iOsnaaente/Medicao-de-consumo-de-agua/README.md

# Monitoramento do consumo de água em chuveiros com arduino e comunicação RF

  Com as crescentes noticias a cerca do uso de forma inadequada da água, uma das preocupações de toda comunidade científica e industrial mais conscientes, está sobre como reduzir o consumo de água através da conscientização das pessoas e criação de aparelhos que consigam economizar os recursos hídricos. Como forma de conscientização a Organização das Nações Unidas (ONU) criou no dia 22 de março de 1992, o Dia Mundial da Água, divulgando a Declaração Universal dos Direitos da Água, entretanto, pouca coisa mudou de lá para cá, pois, as pessoas não tem consciência de quantos litros de água elas gastam por dia e de que forma elas gastam esses recursos.

  Como forma de conscientização, nesse projeto será proposto a criação de um dispositivo que meça o volume de água gasto durante um banho e, que assim, a pessoa que esteja fazendo o uso do chuveiro, possa acompanhar esse consumo durante o processo. Acredita-se que com a visualização do volume total de água gasto durante um banho, o usuário tome consciência de quantos litros de água ele está desperdiçando, muitas vezes com coisas desnecessárias, e assim, o seu tempo de banho seja reduzido, economizando água consequentemente.

  Sabe-se da importância da conscientização a respeito do uso da água e é necessário ter-se os órgãos de apoio ao nosso lado nessa luta, para que se consiga, com sabedoria, usar a água plenamente e assim deixar-se um bom legado para as futuras gerações. Com cada um fazendo a sua parte e economizando, na medida do possível, conseguiremos manter um mundo mais saudável e sem o medo de como será no futuro, tudo graças a tecnologia. A água é um bem de todos e deve ser respeitada. 

# Montagem

Imagem do projeto de Receptor
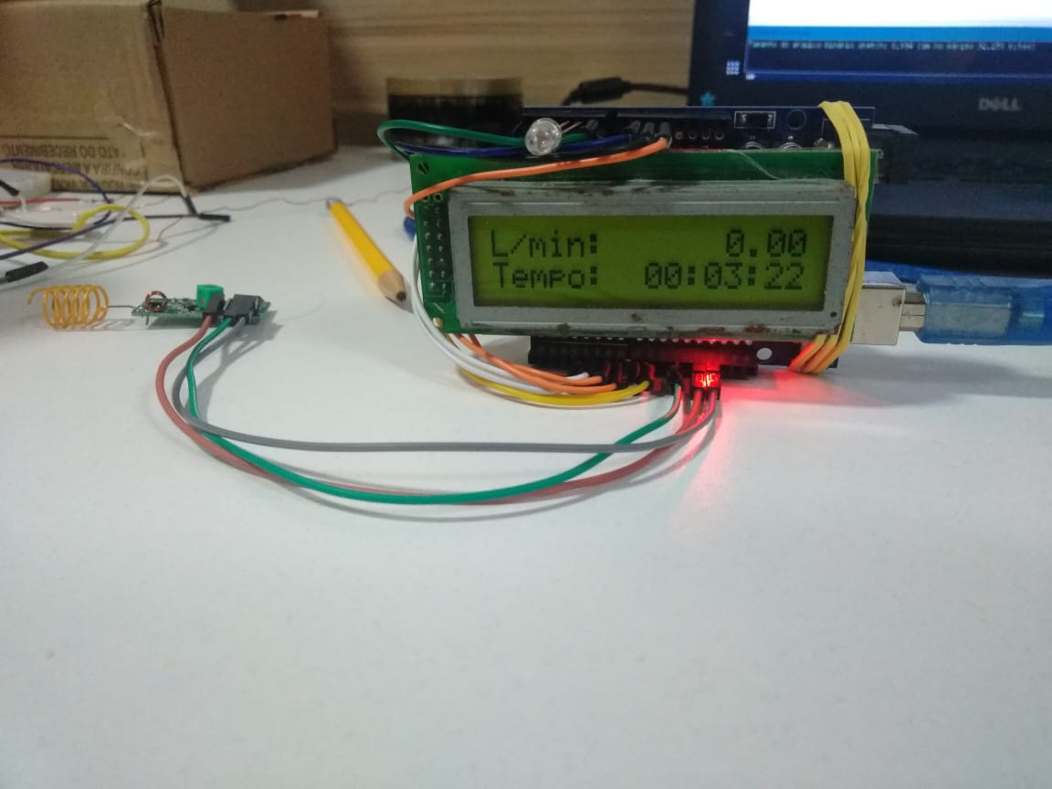
[picture p1: Imagens/Receptor_ (2).jpeg]


Imagem do projeto de Transmissor
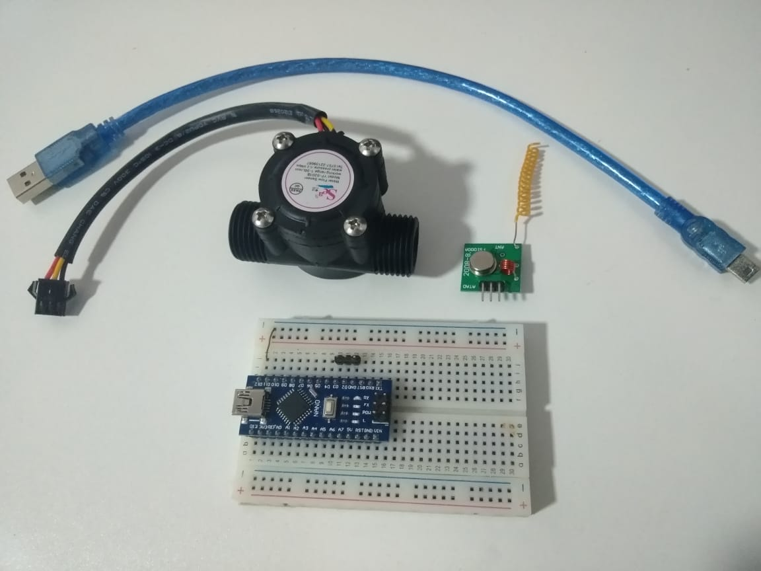
[picture p2: Imagens/Transmissor_ (2).jpeg]

 
 Para saber mais de como foi montado o sistema, visualize o doc.pdf disponível a cima.
 
 *Trabalho desenvolvido na disciplina de Microcontroladores para automação.*
 
 *Universidade Federal de Santa Maria - UFSM.*
