iOsnaaente/Medicao-de-consumo-de-agua/Imagens/Receptor_ (1).jpeg

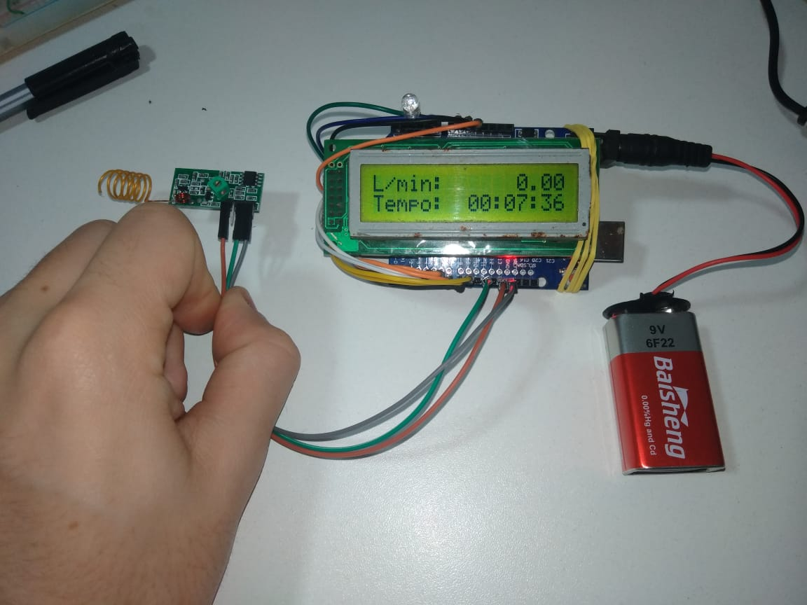
Imagens/Receptor_ (1).jpeg
