iOsnaaente/Medicao-de-consumo-de-agua/Imagens/Receptor_ (3).jpeg

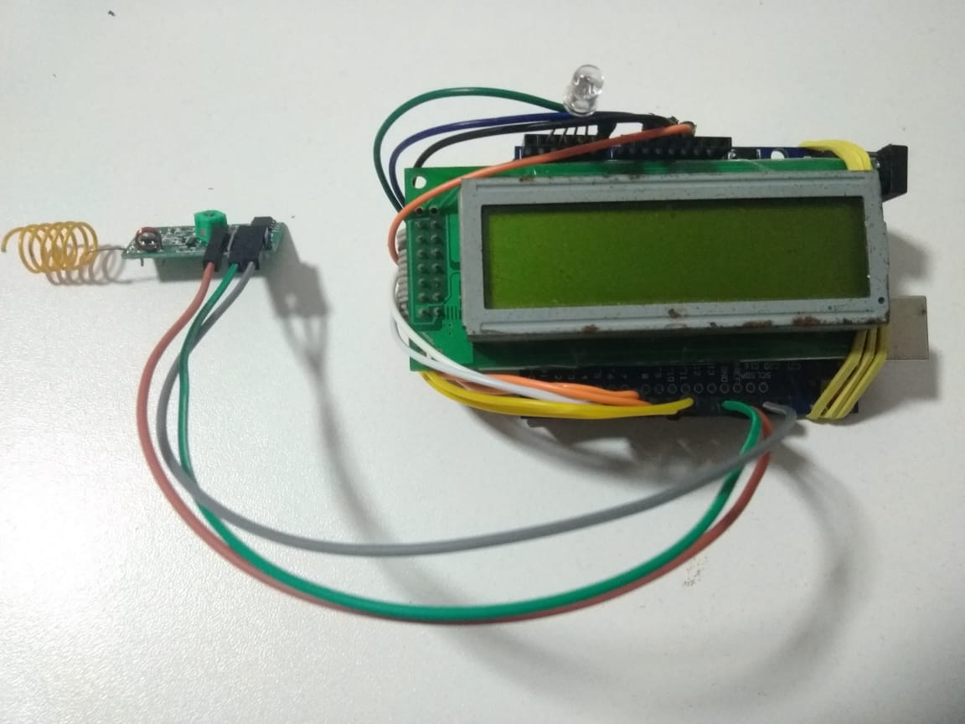
Imagens/Receptor_ (3).jpeg
