iOsnaaente/Medicao-de-consumo-de-agua/Imagens/Receptor_ (4).jpeg

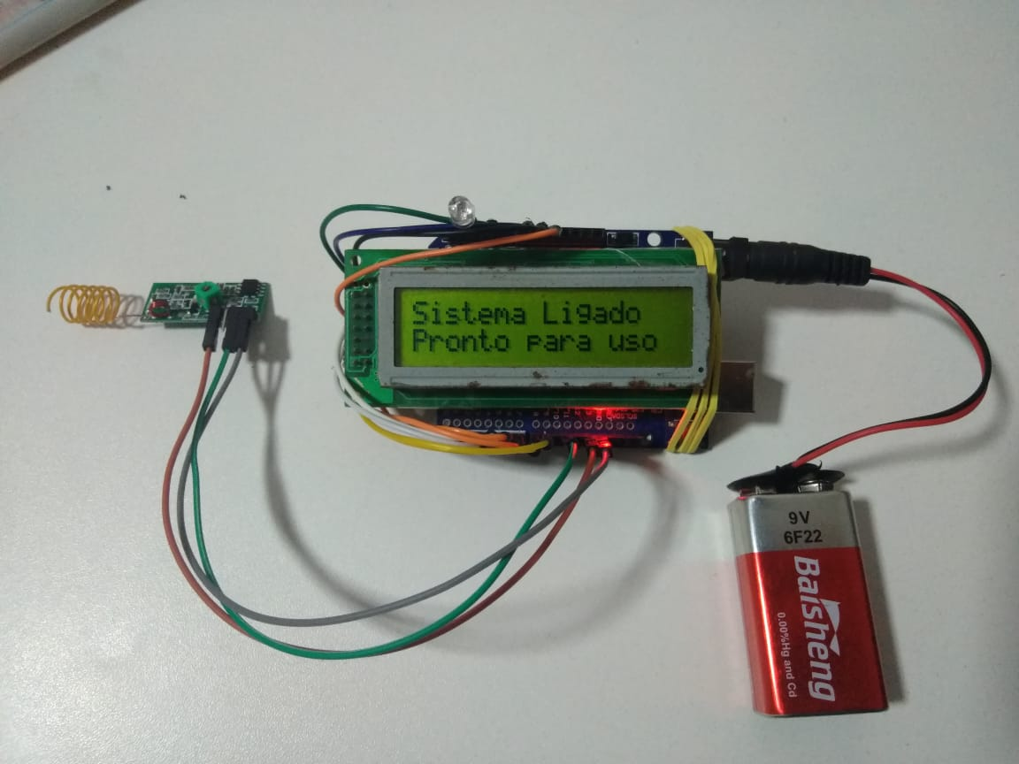
Imagens/Receptor_ (4).jpeg
