iOsnaaente/Medicao-de-consumo-de-agua/Imagens/Receptor_ (5).jpeg

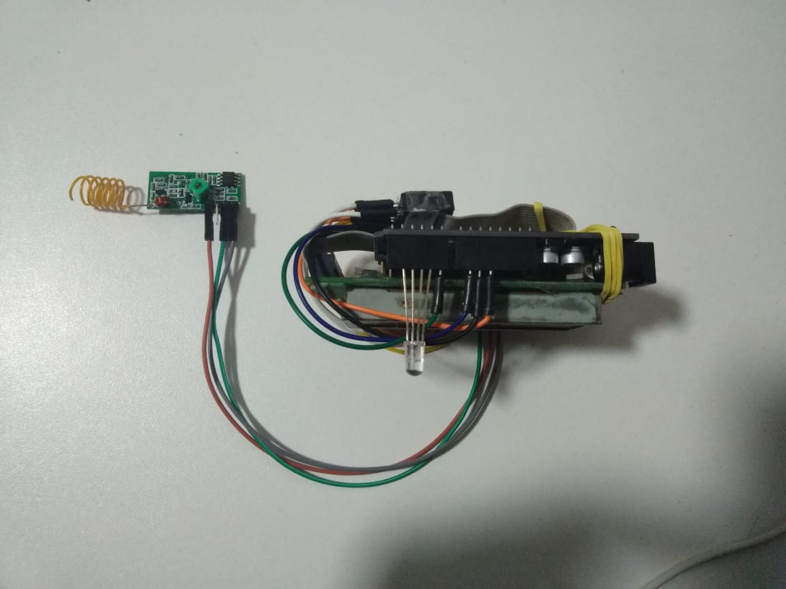
Imagens/Receptor_ (5).jpeg
