iOsnaaente/Medicao-de-consumo-de-agua/Imagens/Receptor_ (6).jpeg

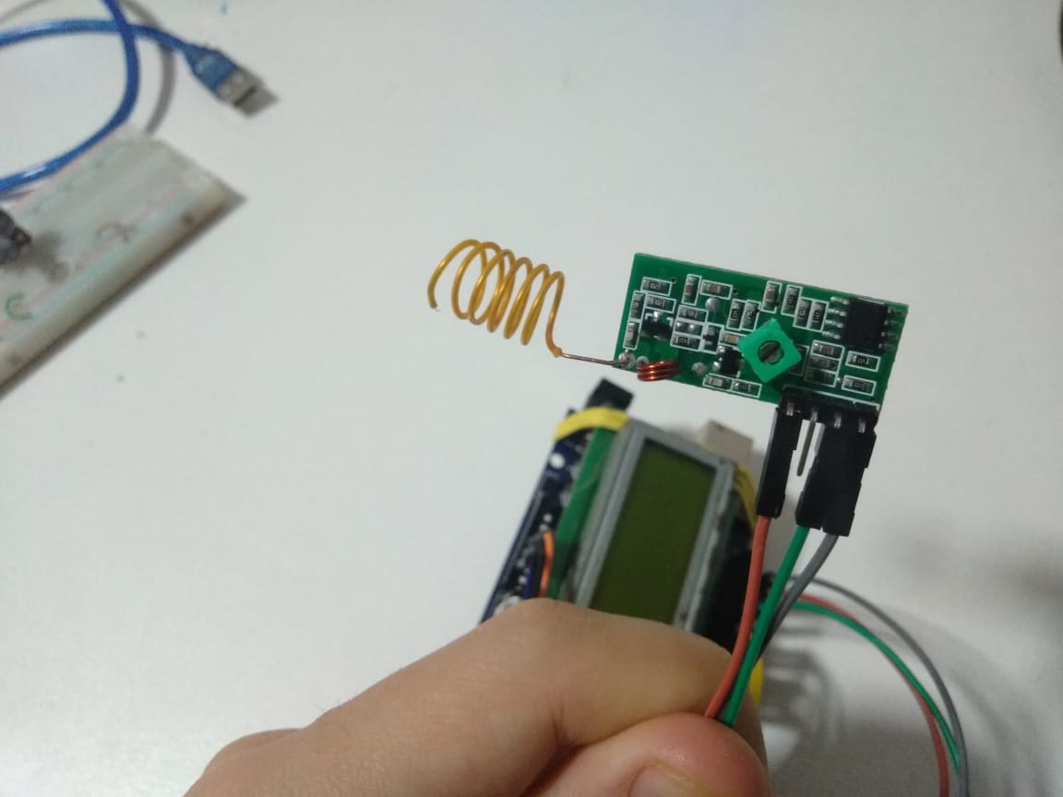
Imagens/Receptor_ (6).jpeg
