iOsnaaente/Medicao-de-consumo-de-agua/Imagens/Transmissor_ (1).jpeg

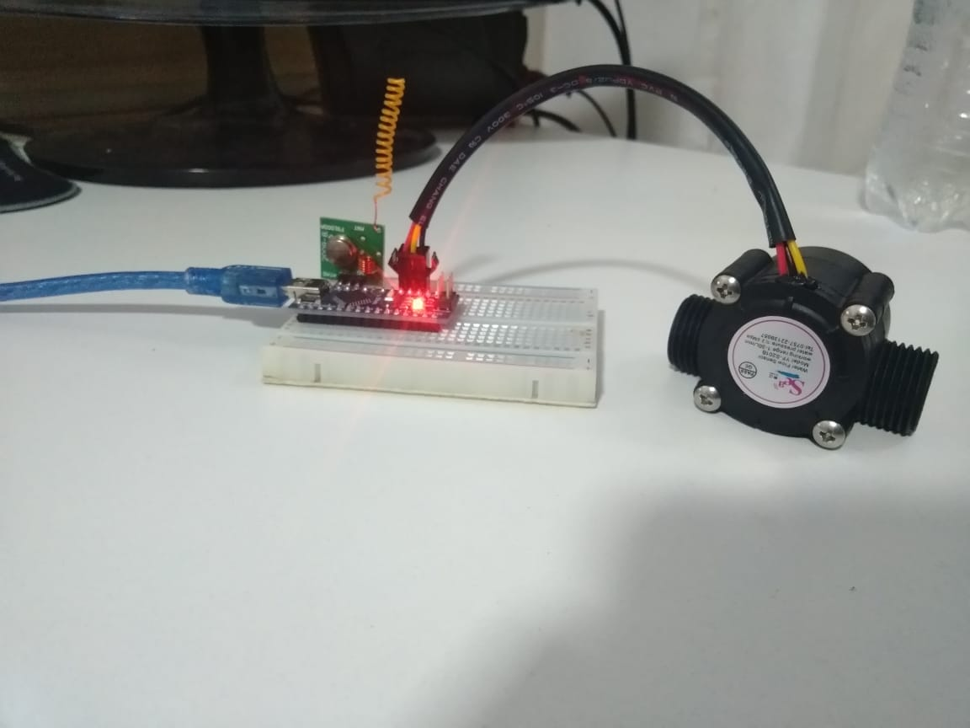
Imagens/Transmissor_ (1).jpeg
