iOsnaaente/Medicao-de-consumo-de-agua/Imagens/Transmissor_ (3).jpeg

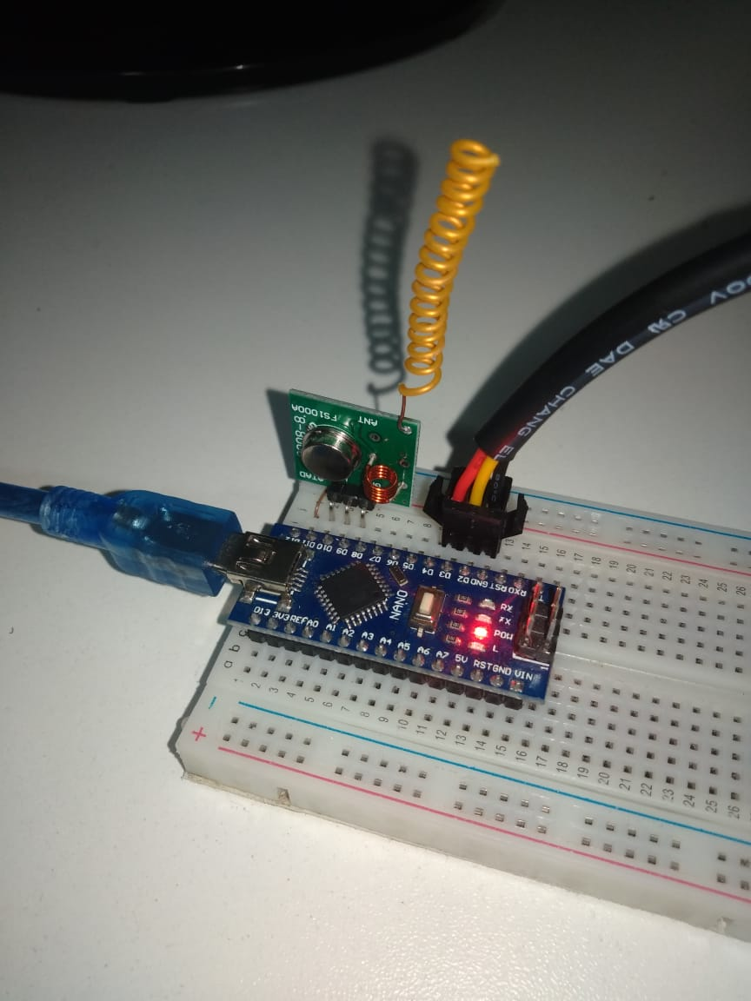
Imagens/Transmissor_ (3).jpeg
