iOsnaaente/Medicao-de-consumo-de-agua/Imagens/Transmissor_ (4).jpeg

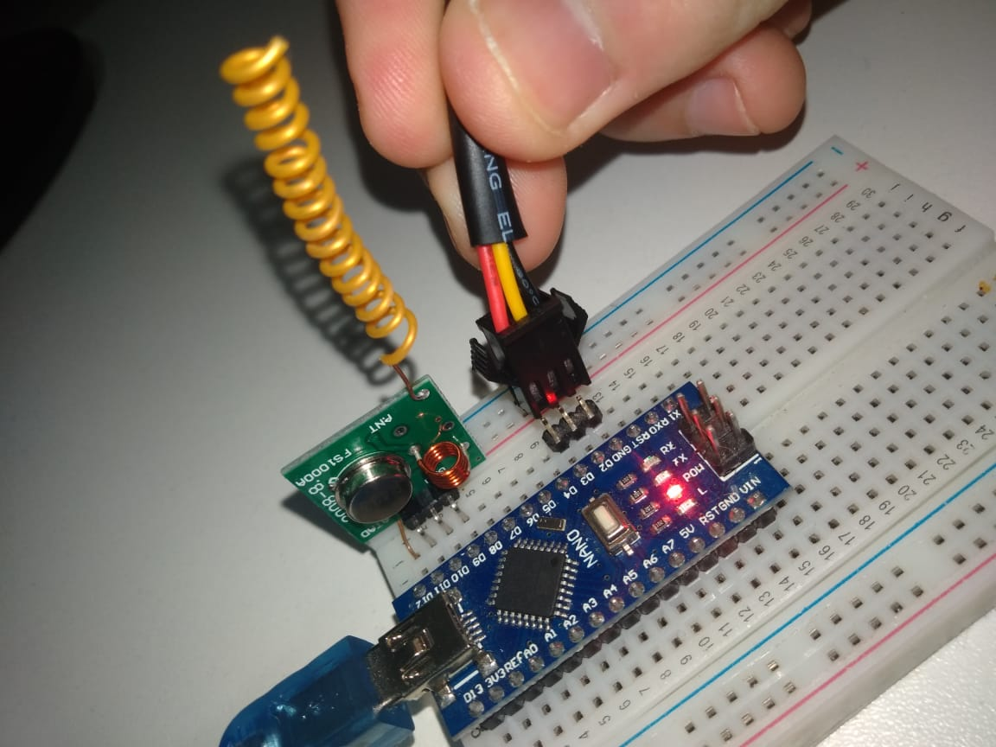
Imagens/Transmissor_ (4).jpeg
