iOsnaaente/Medicao-de-consumo-de-agua/(commit log)

2020-06-09 Sensor de fluxo pronto e funcionando
2020-06-09 Adicionado utils utilizados para o projeto
2020-07-01 Finalizando o sensor de Fluxo
2020-07-02 Sistema de recepção pronto - funcionando OK
